YusufCan13/0-1MHZOSC/OSC.png

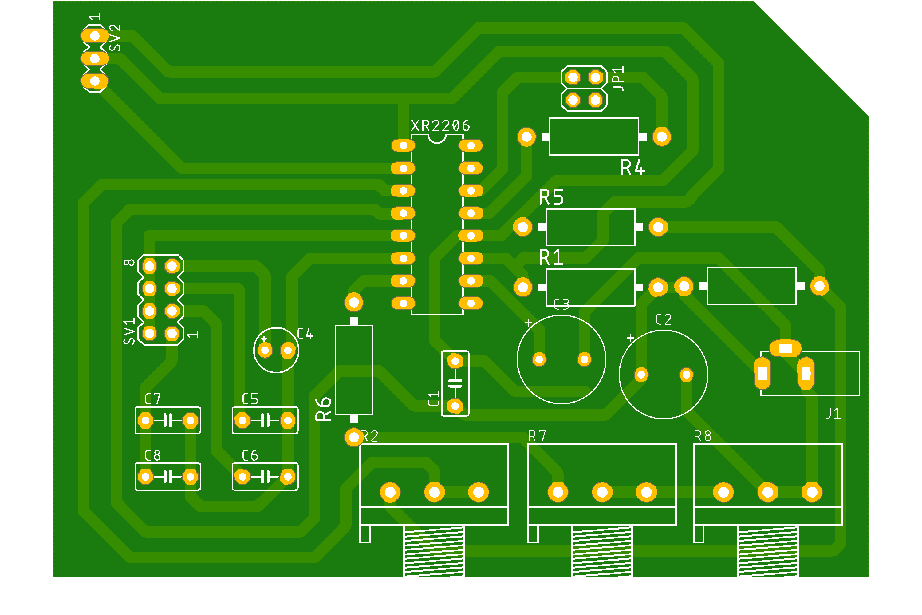
OSC.png
