YusufCan13/0-1MHZOSC/OSC.pdf

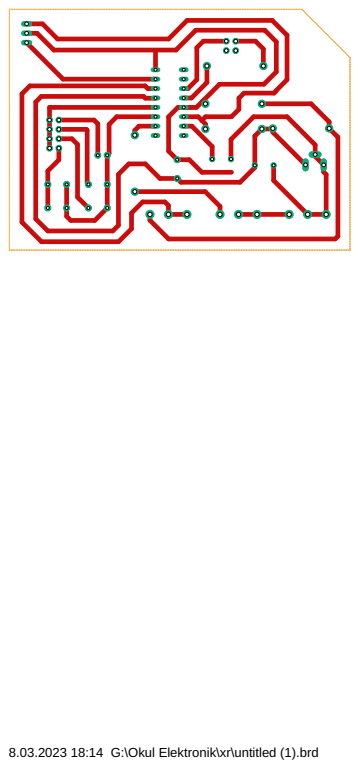
[picture p14: page 1]

8.03.2023 18:14 G:\Okul Elektronik\xr\untitled (1).brd
