YusufCan13/0-1MHZOSC/OSCİLLATOOR.pdf

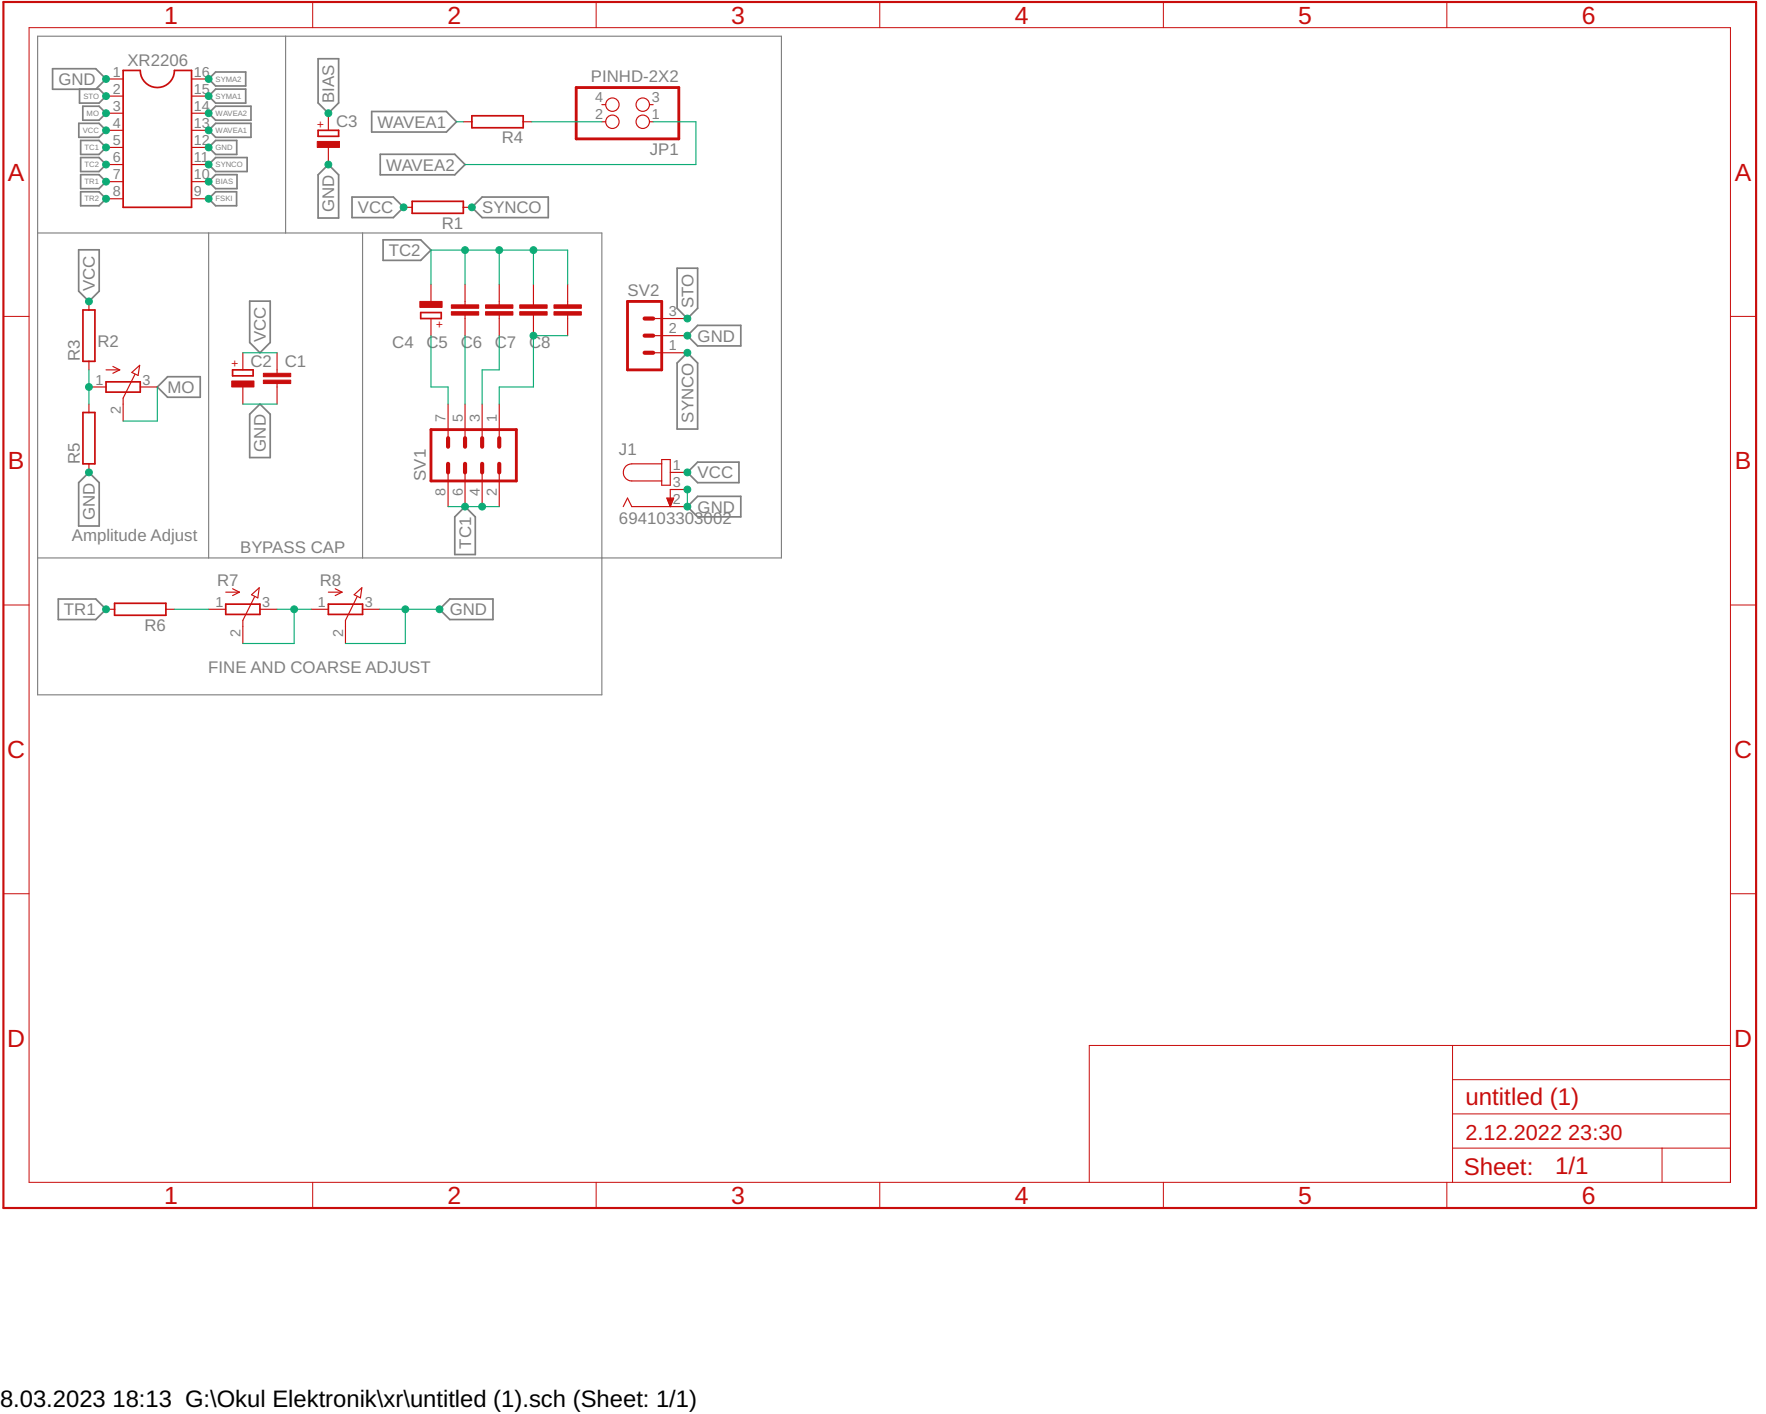
[picture p15: page 1]

FINE AND COARSE ADJUST

8.03.2023 18:13 G:\Okul Elektronik\xr\untitled (1).sch (Sheet: 1/1)
