YusufCan13/0-1MHZOSC/osc devre.brd

## EAGLE design osc devre.brd (2023-03-10)

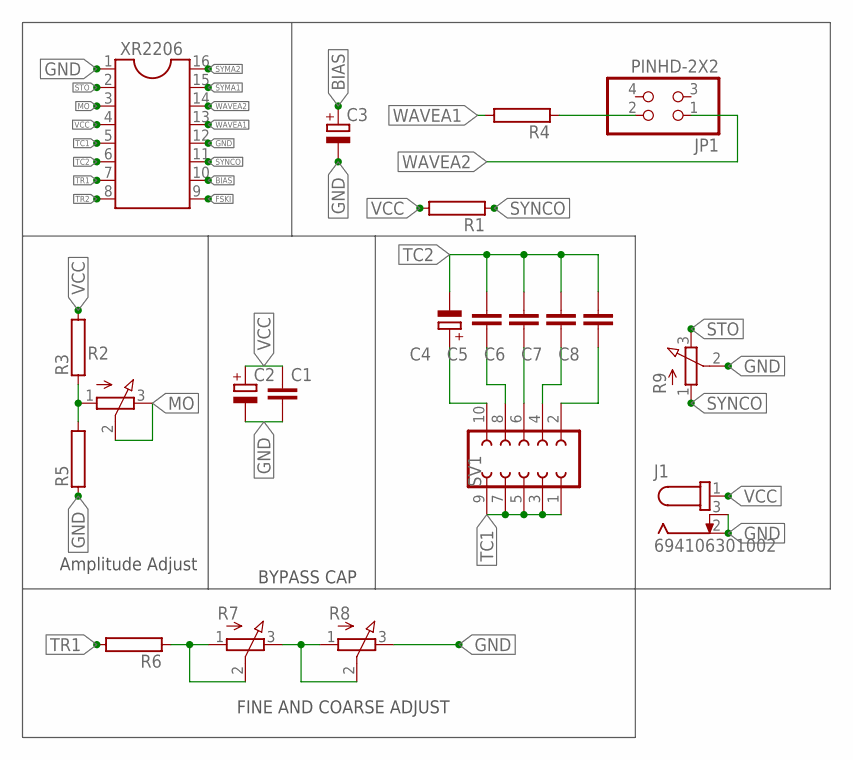
[picture p16: schematic osc devre.sch]

Parts:
C1, C5, C6, C7, C8: C5/3; C5B3
C2, C3: C-POL_RADIAL-11MM-DIA; CAPPRD508W65D1000H1100B
C4: CPOL-EUE2.5-5; E2,5-5
J1: 694106301002
JP1: PINHD-2X2; 2X02
R1, R3, R4, R5, R6: RCA0001; CA0001
R2, R7, R8, R9: 3RP/1610N
SV1: FE05-2
XR2206: DIL16

Connections:
BIAS: C3.1 (+), XR2206.10
FSKI: XR2206.9
GND: C1.2, C2.2 (-), C3.2 (-), J1.2, J1.3, R5.1, R8.3 (E), R9.2 (S), XR2206.1, XR2206.12
MO: R2.2 (S), R2.3 (E), XR2206.3
unnamed: R6.1, R7.1 (A), R7.2 (S)
unnamed: JP1.2, R4.1
unnamed: R7.3 (E), R8.1 (A), R8.2 (S)
unnamed: C8.1, SV1.2
unnamed: R2.1 (A), R3.1, R5.2
unnamed: C7.1, SV1.4
unnamed: C6.1, SV1.6
unnamed: C5.1, SV1.8
unnamed: C4.+, SV1.10
STO: R9.3 (E), XR2206.2
SYMA1: XR2206.15
SYMA2: XR2206.16
SYNCO: R1.1, R9.1 (A), XR2206.11
TC1: SV1.1, SV1.3, SV1.5, SV1.7, SV1.9, XR2206.5
TC2: C4.-, C5.2, C6.2, C7.2, C8.2, XR2206.6
TR1: R6.2, XR2206.7
TR2: XR2206.8
VCC: C1.1, C2.1 (+), J1.1, R1.2, R3.2, XR2206.4
WAVEA1: R4.2, XR2206.13
WAVEA2: JP1.1, XR2206.14

Notes on the sheet:
Amplitude Adjust
BYPASS CAP
FINE AND COARSE ADJUST

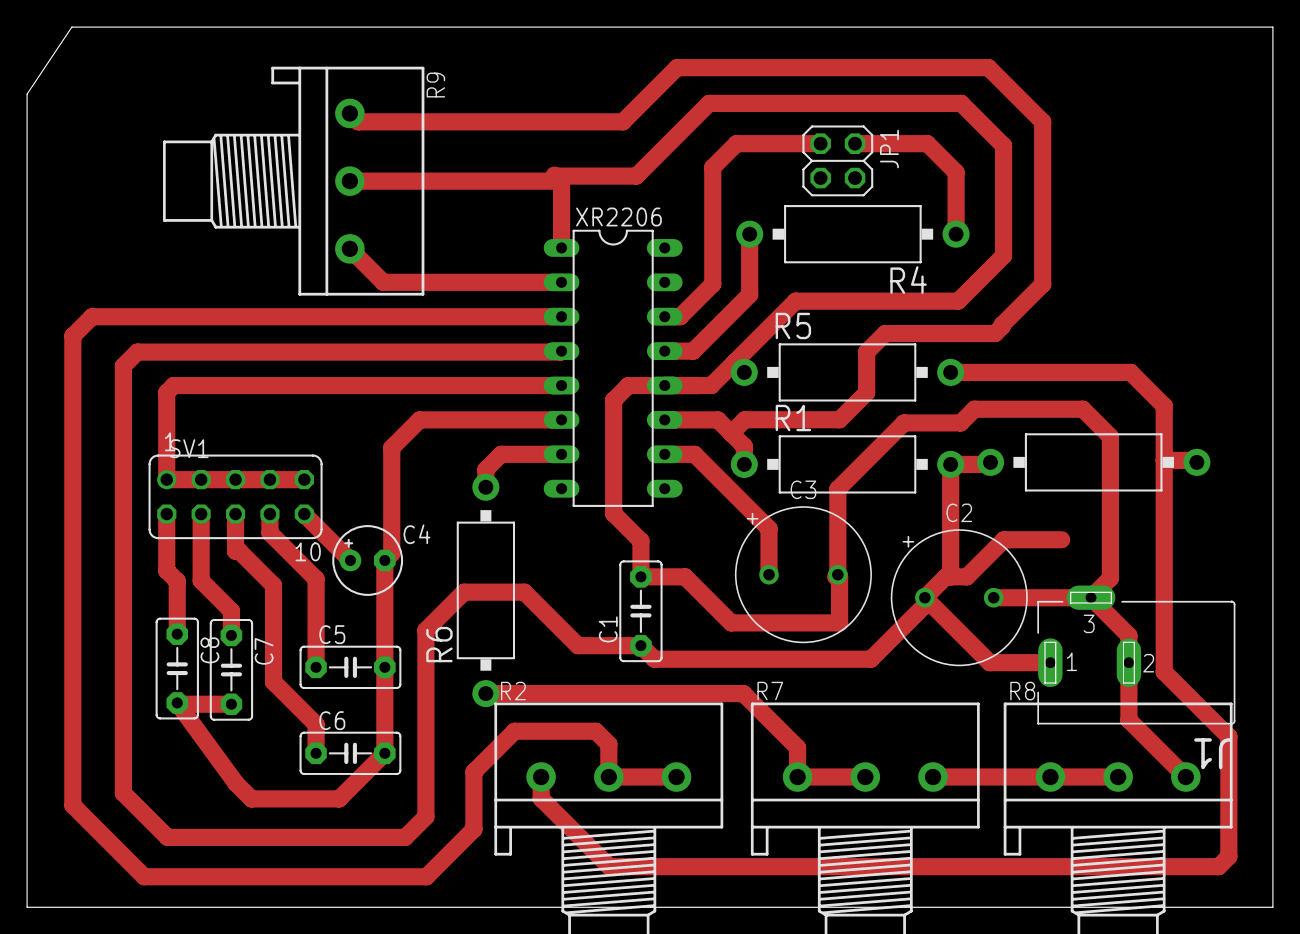
[picture p17: board osc devre.brd from above]

Board: 2 copper layers, 92.0 x 65.0 mm, 21 parts (0 on the bottom side), 20 nets.
